pf-ece/mimeofreq/README.md

# Mimeofreq

Digital delay + phaser combination guitar pedal. Further additions pending.
