pf-ece/mimeofreq/hardware/drill_layout.pdf

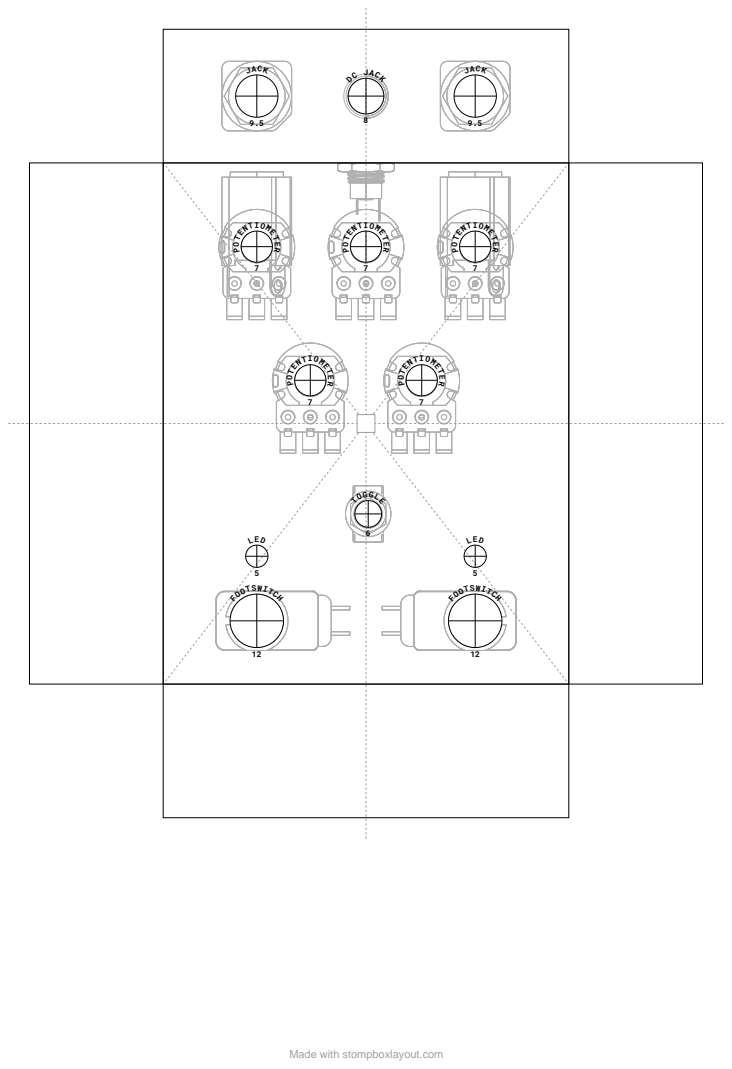
[picture p1: page 1]

Made with stompboxlayout.com
