pf-ece/mimeofreq/hardware/KiCad/mimeofreq.kicad_pcb

## KiCad design hardware/KiCad/mimeofreq.kicad_pcb (2026-09-07)

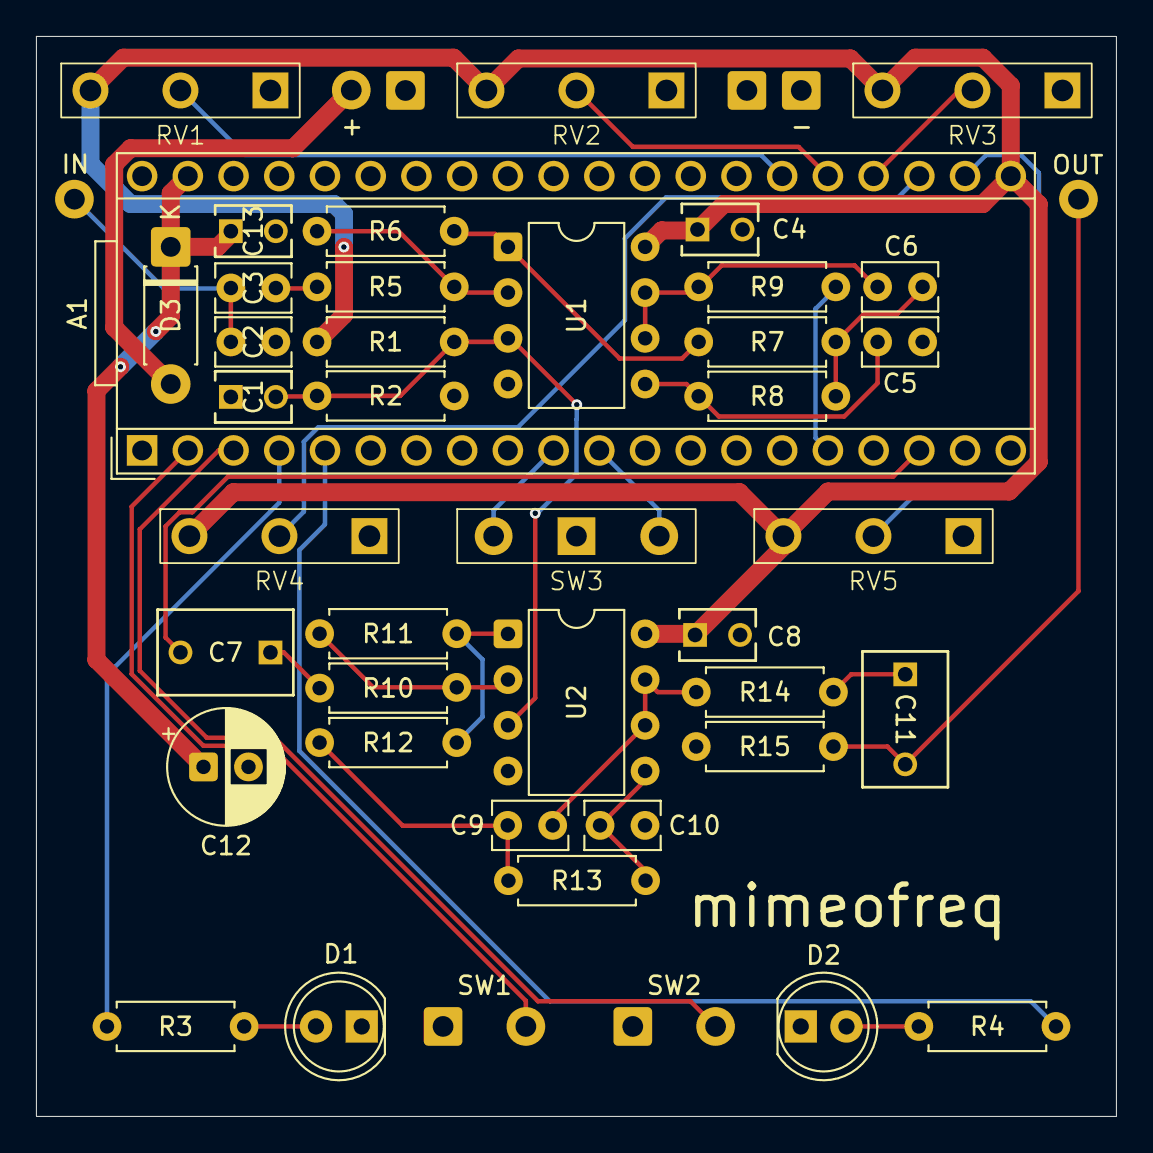
[picture p2: board mimeofreq.kicad_pcb from above]

Board: 2 copper layers, 60.0 x 60.0 mm, 45 parts (0 on the bottom side), 35 nets.

Parts:
A1: Electrosmith_Daisy_Seed_Rev7; Electrosmith_Daisy_Seed
C1, C4, C8, C13: 100n; C_Rect_L4.0mm_W2.6mm_P2.50mm
C2: 100p; C_Rect_L4.0mm_W2.5mm_P2.50mm
C3: 10µ; C_Rect_L4.0mm_W2.5mm_P2.50mm
C5, C9: 1n; C_Rect_L4.0mm_W2.5mm_P2.50mm
C6, C10: 470p; C_Rect_L4.0mm_W2.5mm_P2.50mm
C7, C11: 1µ; C_Rect_L7.3mm_W4.5mm_P5.00mm
C12: 100μ; CP_Radial_D6.3mm_P2.50mm
D1, D2: LED; LED_D5.0mm
D3: 1N5817; D_DO-41_SOD81_P7.62mm_Horizontal
J1, J2: AudioJack2; SolderWire-0.5sqmm_1x02_P4.6mm_D0.9mm_OD2.1mm
J3: Jack-DC; SolderWire-0.5sqmm_1x02_P4.6mm_D0.9mm_OD2.1mm
R1, R2, R15: 100k; R_Axial_DIN0207_L6.3mm_D2.5mm_P7.62mm_Horizontal
R3, R4: 1k; R_Axial_DIN0207_L6.3mm_D2.5mm_P7.62mm_Horizontal
R5: 1M; R_Axial_DIN0207_L6.3mm_D2.5mm_P7.62mm_Horizontal
R6: 1M5; R_Axial_DIN0207_L6.3mm_D2.5mm_P7.62mm_Horizontal
R7, R8, R12, R13: 12k; R_Axial_DIN0207_L6.3mm_D2.5mm_P7.62mm_Horizontal
R9, R14: 100R; R_Axial_DIN0207_L6.3mm_D2.5mm_P7.62mm_Horizontal
R10: 33k; R_Axial_DIN0207_L6.3mm_D2.5mm_P7.62mm_Horizontal
R11: 22k; R_Axial_DIN0207_L6.3mm_D2.5mm_P7.62mm_Horizontal
RV1, RV2, RV3, RV4, RV5: 100k; Potentiometer_P160KN
SW1, SW2: SW_SPST; SolderWire-0.5sqmm_1x02_P4.6mm_D0.9mm_OD2.1mm
SW3: SW_SPDT; SolderWire-0.5sqmm_1x03_P4.6mm_D0.9mm_OD2.1mm_SPDT_OnOn
U1, U2: MCP6022; DIP-8_W7.62mm

Connections:
+3V3: A1.21 (3V3_A), C4.1, C8.1, R1.1, RV1.1, RV2.1, RV3.1, RV4.1, RV5.1, U1.8 (V+), U2.8 (V+)
+9V: D3.2 (A), J3.2
+9VCLEAN: A1.39 (VIN), C12.1, C13.1, D3.1 (K)
/FS1: A1.2 (SD_DATA_3), SW1.2 (B)
/FS2: A1.3 (SD_DATA_2), SW2.2 (B)
/IN: A1.16 (AUDIO_IN_1), R9.2
/Input Buffer/JACK_IN: C2.1, C3.2, J1.T
/LED1: A1.4 (SD_DATA_1), R3.1
/LED2: A1.5 (SD_DATA_0), R4.2
/OUT: A1.18 (AUDIO_OUT_1), C7.2
/Output Buffer/JACK_OUT: C11.2, J2.T, R15.1
/POT1: A1.26 (ADC_4), RV1.2
/POT2: A1.25 (ADC_3), RV2.2
/POT3: A1.24 (ADC_2), RV3.2
/POT4: A1.23 (ADC_1), RV4.2
/POT5: A1.22 (ADC_0), RV5.2
/SPDTa: A1.10 (SPI1_POCI), SW3.1 (A)
/SPDTb: A1.11 (SPI1_PICO), SW3.3 (C)
GND: A1.20 (AGND), A1.40 (DGND), C1.1, C2.2, C4.2, C6.2, C8.2, C10.2, C12.2, C13.2, D1.1 (K), D2.1 (K), J1.S, J2.S, J3.1, R2.2, R15.2, RV1.3, RV2.3, RV3.3, RV4.3, RV5.3, SW1.1 (A), SW2.1 (A), SW3.2 (B), U1.4 (V-), U2.4 (V-)
unnamed: C3.1, R5.1
unnamed: C5.1, R7.2, R8.1
unnamed: C7.1, R10.1
unnamed: C9.1, R12.2, R13.1
unnamed: C11.1, R14.2
unnamed: D1.2 (A), R3.2
unnamed: D2.2 (A), R4.1
unnamed: R6.2, R7.1, U1.1
unnamed: R11.2, R12.1, U2.1
unnamed: R5.2, R6.1, U1.2 (-)
unnamed: C6.1, R8.2, U1.5 (+)
unnamed: C5.2, R9.1, U1.6 (-), U1.7
unnamed: R10.2, R11.1, U2.2 (-)
unnamed: C10.1, R13.2, U2.5 (+)
unnamed: C9.2, R14.1, U2.6 (-), U2.7
VGND: C1.2, R1.2, R2.1, U1.3 (+), U2.3 (+)
