pf-ece/mimeofreq/(commit log)

2026-05-13 Added delay bypass switch.
2026-05-13 Setup for reverse delay mode.
    [freq-fiche.cpp]
2026-05-14 Low-pass filter for smoothing the delay time parameter.
2026-05-16 Implementation of reverse delay mode.
    [freq-fiche.cpp]
2026-05-19 Initial implementation of hold mode with added bug reports.
    [freq-fiche.cpp]
2026-05-21 Initial drill layout.
2026-06-11 Removed 3-mode rotary switch.
2026-06-16 SPDT on-on switch implementation for combo effect modes.
2026-06-22 Initial input buffer LTspice schematic.
2026-06-22 Added temporary component footprints.
2026-06-23 Initial output buffer schematic.
2026-06-23 Implementation of LM7805 voltage regulator.
2026-06-24 Redesigned output buffer: filtering after buffering.
2026-07-18 KiCad schematics on +5V single-supply; GPIO pin reassignments.
    [freq-fiche.kicad_sch, input_buffer.kicad_sch, output_buffer.kicad_sch]
2026-07-22 KiCad schematics on +3V3 single-supply.
    [freq-fiche.kicad_sch, input_buffer.kicad_sch, output_buffer.kicad_sch]
2026-07-22 Set audio callback block size to 2 samples; scrap Hold and Reverse modes.
    [freq-fiche.cpp]
2026-07-23 Lowered phaser patch noise; logarithmic Rate scaling now executed directly using the DaisySP library.
    [freq-fiche.cpp]
2026-07-25 Input buffer simplification; removal of BAS70-04 diodes.
    [freq-fiche.kicad_sch, input_buffer.kicad_sch, output_buffer.kicad_sch]
2026-07-25 Updated LTspice buffer schematic to reflect KiCad schematic.
2026-07-26 DC bias coupling cap.
    [freq-fiche.kicad_sch]
2026-07-28 Reduction in number of op amps from 5 to 4.
    [freq-fiche.kicad_sch, input_buffer.kicad_sch, output_buffer.kicad_sch]
2026-07-29 Footprint assignments for most components; file organization.
    [freq-fiche.kicad_sch, input_buffer.kicad_sch, output_buffer.kicad_sch]
2026-07-29 Completed initial footprint assignments; courtyard edits.
    [freq-fiche.kicad_sch]
2026-07-31 Added power flags.
    [freq-fiche.kicad_sch, input_buffer.kicad_sch, output_buffer.kicad_sch]
2026-08-01 Power conditioning.
    [freq-fiche.kicad_sch, input_buffer.kicad_sch, output_buffer.kicad_sch, power_conditioner.kicad_sch]
2026-08-01 Initial PCB BOM.
    [pcb_bom.csv]
2026-08-09 Gain staging; source pin reassignments.
    [input_buffer.kicad_sch, output_buffer.kicad_sch, pcb_bom.csv]
2026-08-10 Changed file names from working project title 'Freq-Fiche' to new project title 'Mimeofreq'.
    [freq-fiche.kicad_sch, input_buffer.kicad_sch, mimeofreq.kicad_sch, mimf_pcb_bom.csv, output_buffer.kicad_sch, power_conditioner.kicad_sch]
2026-08-11 Removed redundant sample rate float variable.
2026-08-12 Added pot diameter to silkscreen.
    [input_buffer.kicad_sch, mimeofreq.kicad_sch, output_buffer.kicad_sch, power_conditioner.kicad_sch]
2026-08-18 Initial board.
    [mimeofreq.kicad_pcb]
2026-08-18 Adding op amps to board; bypass cap correction.
    [input_buffer.kicad_sch, mimeofreq.kicad_pcb, mimeofreq.kicad_sch, output_buffer.kicad_sch]
2026-08-18 Removed unneeded LTspice/schematics subfolder.
2026-08-18 Initial resistor board placement.
    [mimeofreq.kicad_pcb]
2026-08-29 All components fit on PCB. Some footprints replaced.
    [input_buffer.kicad_sch, mimeofreq.kicad_pcb, power_conditioner.kicad_sch]
2026-09-01 Upper half initial routing.
    [mimeofreq.kicad_pcb]
2026-09-02 Full board initial routing.
    [mimeofreq.kicad_pcb]
2026-09-02 Reference fields.
    [mimeofreq.kicad_pcb]
2026-09-03 Silkscreen text (jacks).
    [mimeofreq.kicad_pcb]
2026-09-03 Pot diameter footprint moved to f. silkscreen.
2026-09-03 Silkscreen text (title).
    [mimeofreq.kicad_pcb]
2026-09-07 Ground plane.
    [mimeofreq.kicad_pcb]
